Huaimaxin-zh/balance-car/README.md

此项目是基于江协科技平衡车开发的，仅用于个人练习作用

相对改动：

1、mpu6050换成了icm20602，不过制作PCB时没想到用spi，所以用的还是i2c

2、电机改成了轮趣科技的JGA25-370 12V rpm620

记录一下自己的改动历程，也或者说是改动心得

1）/\*atan2计算反正切，得到角度（弧度制）， / 3.14159 \* 180可将弧度制转为角度值\*/

&#x09;	AngleAcc = -atan2(AX, AZ) / 3.14159 \* 180;

&#x20;   【一定要用vofa看看AngleAcc的跳动正不正常，不正常的话，极大概率是atan2前面的要给-】

2）Angle有零漂的话，先调整AngleAcc，减去AngleAcc的零漂值大概率就能使Angle在零位。

3）10.22 增加了积分限幅和输出偏移，但是感觉对平衡车重心偏前没什么作用

4）10.22 增加了角速度环，同时放弃Angle的水平零度，把重心纳入考虑范围，修改AngleAcc为-=5.0，同时给了-6的输出偏移，成功做出了不抖，较为丝滑的平衡小车，目前会前后小幅移动

5）10.23 把输出偏移置0了，感觉输出偏移给-6会往后倒，同时还发现一点，就是大力推一下会叠加速度，一直往一个方向跑，明天早上过来加个速度环看看能不能遏制这种情况

6）10.23 增加了速度环，发现果然就是这个问题，加了速度环之后推了也能保持基本静止，而不是往前往后跑了。至于为什么没有早上调试而是凌晨调试，是因为学校关门了，出不去了，下次要赶在十一点前出门，现在只能调车了。

7）10.23 增加了角度环，现在走的挺直的。还加了一个微分先行，但目前没有看出有什么效果，接下来打算把蓝牙控制给加上

8） 10.23 增加了蓝牙控制，这个代码是直接搬过来的，先测试一下能不能用，能用的话，用现成的遥控器先测试一下，等过几天再搓一个自己的遥控器出来

9）10.24 之前copy的蓝牙模块有问题，首先是我之前的蓝牙是hc-06，不好用，是经典蓝牙，只有安卓手机才能使用，所以我换成了hc-04.然后是之前蓝牙模块代码数据解析用的USART1的函数Serial\_RxFlag，那个人只用了蓝牙，没有串口，所以直接把蓝牙放在串口里了，没单独设立蓝牙模块。我既有蓝牙又有串口，所以我的蓝牙是USART2，我的函数是BlueSerial\_RxFlag，这一整套都要换。现在修复好了蓝牙，发现我的转向环好像没作用，现在修复一下转向环

10）10.24转向换的出问题是因为代码写错了，DifPWM=TurnPID.Out——这个是正确的代码，要把转向环算出值赋值给DifPWM，我写成了TurnPID.Target = TurnPID.Out，所以转向环根本没起作用

11）10.24 现在已经基本能遥控了，但是遥控启停震荡还是比较大的，之后找个时间再调调。然后突然想起来，现在的PCB还是有缺陷的，STM32烧录的排针靠着电机驱动，太挤了，位置没规划好，应该转个180度的。接下来先把遥控器做了。
