Huaimaxin-zh/balance-car/balance_car PCB/BOM_Board1_PCB1_2026-09-22.xlsx

No. | Quantity | Comment | Designator | Footprint | Value | Manufacturer Part | Manufacturer | Supplier Part | Supplier
1 | 2 | 100nF | C1,C3 | C0603 | 100nF
2 | 2 | 10nF | C2,C4 | C0603 | 10nF
3 | 2 | 22uF | C5,C10 | C0603_1 | 22uF
4 | 3 | 22uF | C6,C7,C13 | C0805 | 22uF
5 | 3 | 100nF | C8,C11,C12 | C0603_1 | 100nF
6 | 1 | 33pF | C9 | C0603_1 | 33pF
7 | 1 | 220uF | C14 | CAP-SMD_BD6.3-L6.6-W6.6-LS7.3-FD-H7.7 | 220uF | JVJ25V220M6x8 | JIERR(捷而瑞) | C46550404 | LCSC
8 | 1 | XT30UPB-F | CN1 | CONN-TH_XT30UPB-F |  | XT30UPB-F | AMASS(艾迈斯) | C108769 | LCSC
9 | 1 | BZT52C18 | D2 | SOD-123_L2.8-W1.8-LS3.7-RD |  | BZT52C18 | MDD | C173425 | LCSC
10 | 1 | HDR-F_2.54_2x4 | H1 | HDR-TH_8P-P2.54-V-F-R2-C4-S2.54-1 |  |  |  | C92271
11 | 3 | HDR-F_2.54_1x6P | H2,H4,H5 | HDR-TH_6P-P2.54-V-F |  |  |  | C40877
12 | 1 | HDR-F_2.54_1x8P | H3 | HDR-TH_8P-P2.54-V-F-1 |  |  |  | C27438
13 | 1 | HDR-F_2.54_1x4P | H6 | HDR-TH_4P-P2.54-V-F |  |  |  | C2718488
14 | 1 | stm32 | H7 | STM32
15 | 1 | 4.7uH | L1 | IND-SMD_L5.4-W5.2_FXL0530_1 | 4.7uH | FXL0530-4R7-M | cjiang(长江微电) | C177246 | LCSC
16 | 1 | LED_0603-G | LED1 | LED_0603
17 | 1 | 0.96OLED模块_4P | OLED1 | 0.96OLED_4P
18 | 1 | HY19P03D | Q2 | TO-252-2_L6.6-W6.1-P4.57-LS9.9-TL-CW |  | HY19P03D | HUAYI(华羿微) | C122492 | LCSC
19 | 1 | 10K | R1 | R0603 | 10K
20 | 1 | 2.7K | R2 | R0603 | 2.7K
21 | 2 | 100K | R3,R5 | R0603_1 | 100K
22 | 1 | 7.5K | R4 | R0603_1 | 7.5K
23 | 1 | 9.09K | R6 | R0603_1 | 9.09K
24 | 1 | 40.2K | R7 | R0603_1 | 40.2K
25 | 1 | 20K | R8 | R0603_1 | 20K
26 | 1 | 10 | R9 | R0603_1 | 10
27 | 4 | M3螺丝 | SCREW1,SCREW2,SCREW3,SCREW4 | M3螺丝
28 | 1 | SS-12D10L5 | SW1 | SW-TH_SS-12D10L5 |  | SS-12D10L5 | XKB Connection(中国星坤) | C319012 | LCSC
29 | 4 | Key_SMD_3x4x2 | SW2,SW3,SW4,SW5 | Key_SMD_3x4x2
30 | 1 | MP2315SGJ-Z | U1 | TSOT-23-8_L2.9-W1.6-P0.65-LS2.8-BL |  | MP2315SGJ-Z | MPS(芯源) | C3031493 | LCSC
31 | 1 | SMBJ16A | U2 | SMB_L4.6-W3.5-LS5.3-RD |  | SMBJ16A | R+O(宏嘉诚) | C19077571 | LCSC
32 | 1 | RT9013-33GB | U4 | SOT-23-5_L3.0-W1.7-P0.95-LS2.8-BR |  | RT9013-33GB | RICHTEK(台湾立锜) | C47773 | LCSC
33 | 1 | TB6612电机驱动 | U7 | TB6612电机驱动
