Huaimaxin-zh/balance-car/balance_car model/PCB.SLDPRT

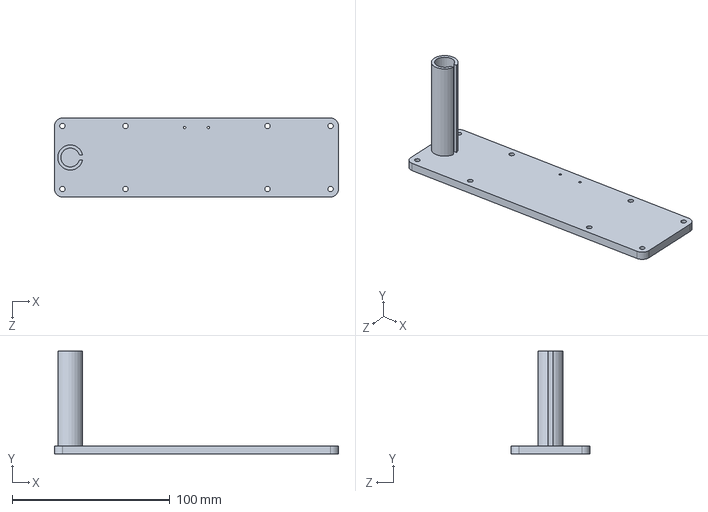
[picture p1: CAD file, 2026-10-22]
balance_car model/PCB.SLDPRT
180.0 x 65.0 x 50.0 mm
