Huaimaxin-zh/balance-car/balance_car model/小车底盘.SLDPRT

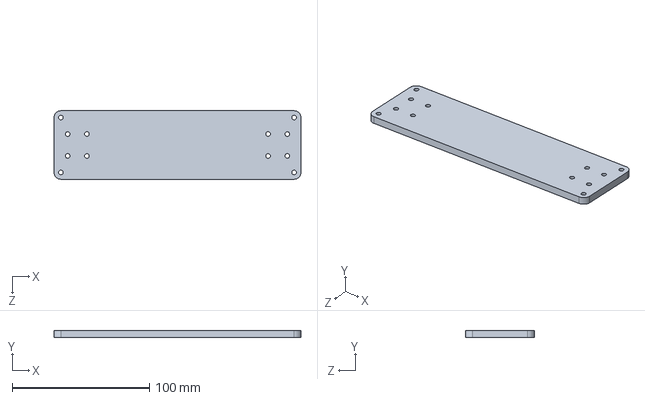
[picture p2: CAD file, 2026-10-22]
balance_car model/小车底盘.SLDPRT
180.0 x 5.00 x 50.0 mm
