Huaimaxin-zh/balance-car/(list of files, cad)

Other CAD files:
balance_car model/装配体2.SLDASM
