Huaimaxin-zh/balance-car/balance_car code/Hardware/Serial.h

#ifndef __SERIAL_H
#define __SERIAL_H

#include <stdio.h>

extern char Serial_RxPacket[];
void Serial_Init(void);
void Serial_SendByte(uint8_t Byte);
void Serial_SendArray(uint8_t *Array, uint16_t Length);
void Serial_SendString(char *String);
void Serial_SendNumber(uint32_t Number, uint8_t Length);
void Serial_Printf(char *format, ...);

uint8_t Serial_GetRxFlag(void);
uint8_t Serial_GetRxData(void);

extern uint8_t Serial_RxFlag;

#endif
