Huaimaxin-zh/balance-car/(commit log)

2026-10-22 角度环直立平衡车工程v1.0
2026-10-22 增加README
2026-10-22 SW模型和PCB
2026-10-22 PCB制版文件和BOM表
2026-10-22 SW模型和装配体
2026-10-22 角度环控制平衡车直立v1.0
2026-10-22 角度环控制平衡车直立v1.1--减去了AngleAcc零漂
2026-10-22 增加了一些改动心得，主要关于AngleAcc
2026-10-22 增加了积分限幅和输出偏移
2026-10-22 记录了一下10.22，增加积分限幅和输出偏移，但作用不大
2026-10-22 增加了一个角速度环，同时不再追求平放时角度，而是把重心考虑进去，微调了AngleAcc，同时用了一点输出偏移
2026-10-22 写了一下加角速度环和调好重心的心得，现在只会前后小幅度移动了
2026-10-22 把输出偏移置为0了
2026-10-22 把输出偏移置0了，提出了一下潜在问题，用力推会朝一个方向叠加速度，明天来解决，加一个速度环试试先
2026-10-22 增加了速度环，解决了一碰就速度叠加的问题
2026-10-22 增加了速度环，解决了部分问题，告诫了一下自己
2026-10-22 增加了角度环
2026-10-22 增加了角度环，加了个微分先行
2026-10-22 增加了蓝牙控制
2026-10-22 增加了蓝牙，之后拿现成的遥控器试试连接，再过几天自己搓个遥控器
2026-10-24 修复了蓝牙功能，但发现转向环还存在问题
2026-10-24 记录了一下之前为什么无法使用蓝牙，以及接下来要修复转向环
2026-10-24 修复了转向环无法正常调用的问题，现在能正常用蓝牙遥控了
2026-10-24 修复了转向环，纯手误
2026-10-24 小车蓝牙遥控震荡较大，讲了一下现在PCB的问题，以及下一步做遥控器
